pjones79/streamlit_dashboard-app.py/TheFlightWall_OSS-main/streamlit_dashboard/assets/virgin_atlantic_787.png

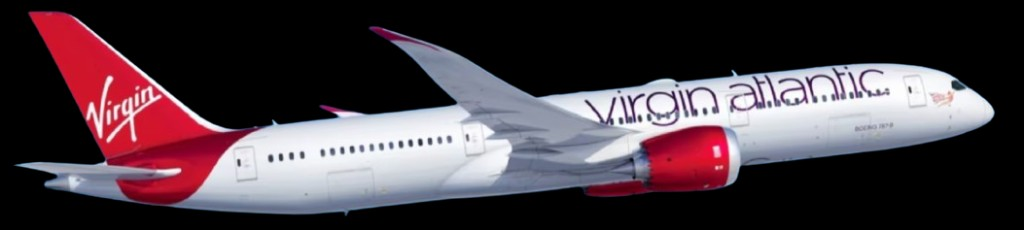
TheFlightWall_OSS-main/streamlit_dashboard/assets/virgin_atlantic_787.png
