pjones79/streamlit_dashboard-app.py/TheFlightWall_OSS-main/brackets/rectangle_bracket.stl

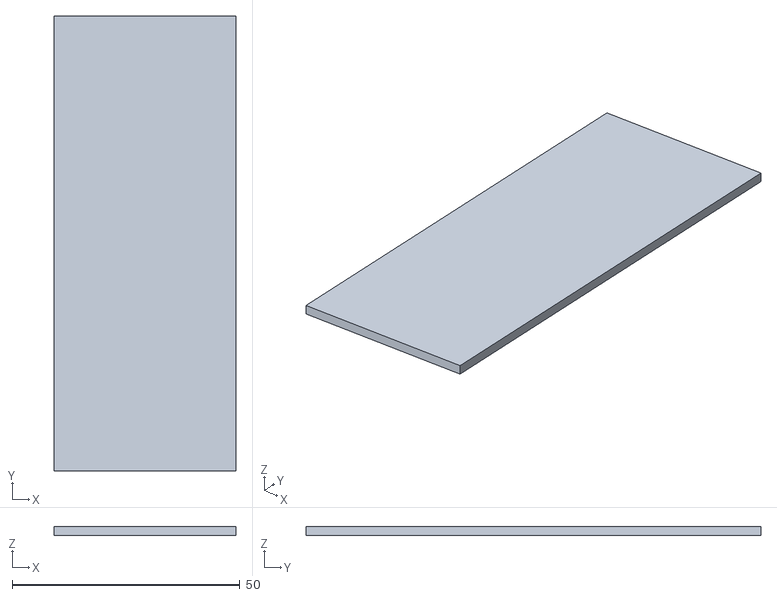
[picture p4: CAD file, 2026-05-08]
TheFlightWall_OSS-main/brackets/rectangle_bracket.stl
40.0 x 100.0 x 2.00
