pjones79/streamlit_dashboard-app.py/TheFlightWall_OSS-main/brackets/plus_bracket.stl

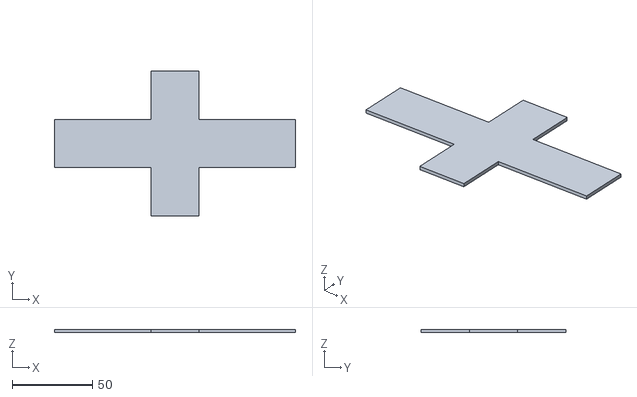
[picture p5: CAD file, 2026-05-08]
TheFlightWall_OSS-main/brackets/plus_bracket.stl
150.0 x 90.0 x 2.00
