pjones79/streamlit_dashboard-app.py/TheFlightWall_OSS-main/firmware/adapters/FlightWallFetcher.h

#pragma once

#include <Arduino.h>
#include <HTTPClient.h>
#include <WiFiClientSecure.h>
#include <ArduinoJson.h>
#include "config/APIConfiguration.h"

class FlightWallFetcher
{
public:
    FlightWallFetcher() = default;
    ~FlightWallFetcher() = default;

    bool getAirlineName(const String &airlineIcao, String &outDisplayNameFull);

    bool getAircraftName(const String &aircraftIcao,
                         String &outDisplayNameShort,
                         String &outDisplayNameFull);

private:
    bool httpGetJson(const String &url, String &outPayload);
};
