pjones79/streamlit_dashboard-app.py/TheFlightWall_OSS-main/firmware/adapters/AeroAPIFetcher.h

#pragma once

#include <Arduino.h>
#include <HTTPClient.h>
#include <WiFiClientSecure.h>
#include <ArduinoJson.h>
#include "interfaces/BaseFlightFetcher.h"
#include "config/APIConfiguration.h"

class AeroAPIFetcher : public BaseFlightFetcher
{
public:
    AeroAPIFetcher() = default;
    ~AeroAPIFetcher() override = default;

    bool fetchFlightInfo(const String &flightIdent, FlightInfo &outInfo) override;
};
