pjones79/streamlit_dashboard-app.py/TheFlightWall_OSS-main/firmware/adapters/NeoMatrixDisplay.h

#pragma once

#include <stdint.h>
#include <vector>
#include "interfaces/BaseDisplay.h"

class FastLED_NeoMatrix;
struct CRGB;

class NeoMatrixDisplay : public BaseDisplay
{
public:
    NeoMatrixDisplay();
    ~NeoMatrixDisplay() override;

    bool initialize() override;
    void clear() override;
    void displayFlights(const std::vector<FlightInfo> &flights) override;
    void displayMessage(const String &message);
    void showLoading();

private:
    FastLED_NeoMatrix *_matrix = nullptr;
    CRGB *_leds = nullptr;

    uint16_t _matrixWidth = 0;
    uint16_t _matrixHeight = 0;
    uint32_t _numPixels = 0;

    size_t _currentFlightIndex = 0;
    unsigned long _lastCycleMs = 0;

    void drawTextLine(int16_t x, int16_t y, const String &text, uint16_t color);
    String makeFlightLine(const FlightInfo &f);
    String truncateToColumns(const String &text, int maxColumns);
    void displaySingleFlightCard(const FlightInfo &f);
    void displayLoadingScreen();
};
