pjones79/streamlit_dashboard-app.py/TheFlightWall_OSS-main/firmware/adapters/OpenSkyFetcher.h

#pragma once

#include <Arduino.h>
#include <HTTPClient.h>
#include <ArduinoJson.h>
#include "interfaces/BaseStateVectorFetcher.h"
#include "utils/GeoUtils.h"
#include "config/APIConfiguration.h"
#include "config/UserConfiguration.h"

class OpenSkyFetcher : public BaseStateVectorFetcher
{
public:
    OpenSkyFetcher() = default;
    ~OpenSkyFetcher() override = default;

    bool fetchStateVectors(double centerLat,
                           double centerLon,
                           double radiusKm,
                           std::vector<StateVector> &outStateVectors) override;

    bool ensureAuthenticated(bool forceRefresh = false);

private:
    String m_accessToken;
    unsigned long m_tokenExpiryMs = 0;

    bool ensureAccessToken(bool forceRefresh = false);
    bool requestAccessToken(String &outToken, unsigned long &outExpiryMs);
};
